ck1-dev/ESPuino/PCBs/Wemos Lolin D32 Pro ck1/espuino_lolin_d32_pro.kicad_pcb

## KiCad design PCBs/Wemos Lolin D32 Pro ck1/espuino_lolin_d32_pro.kicad_pcb (2021-09-25)

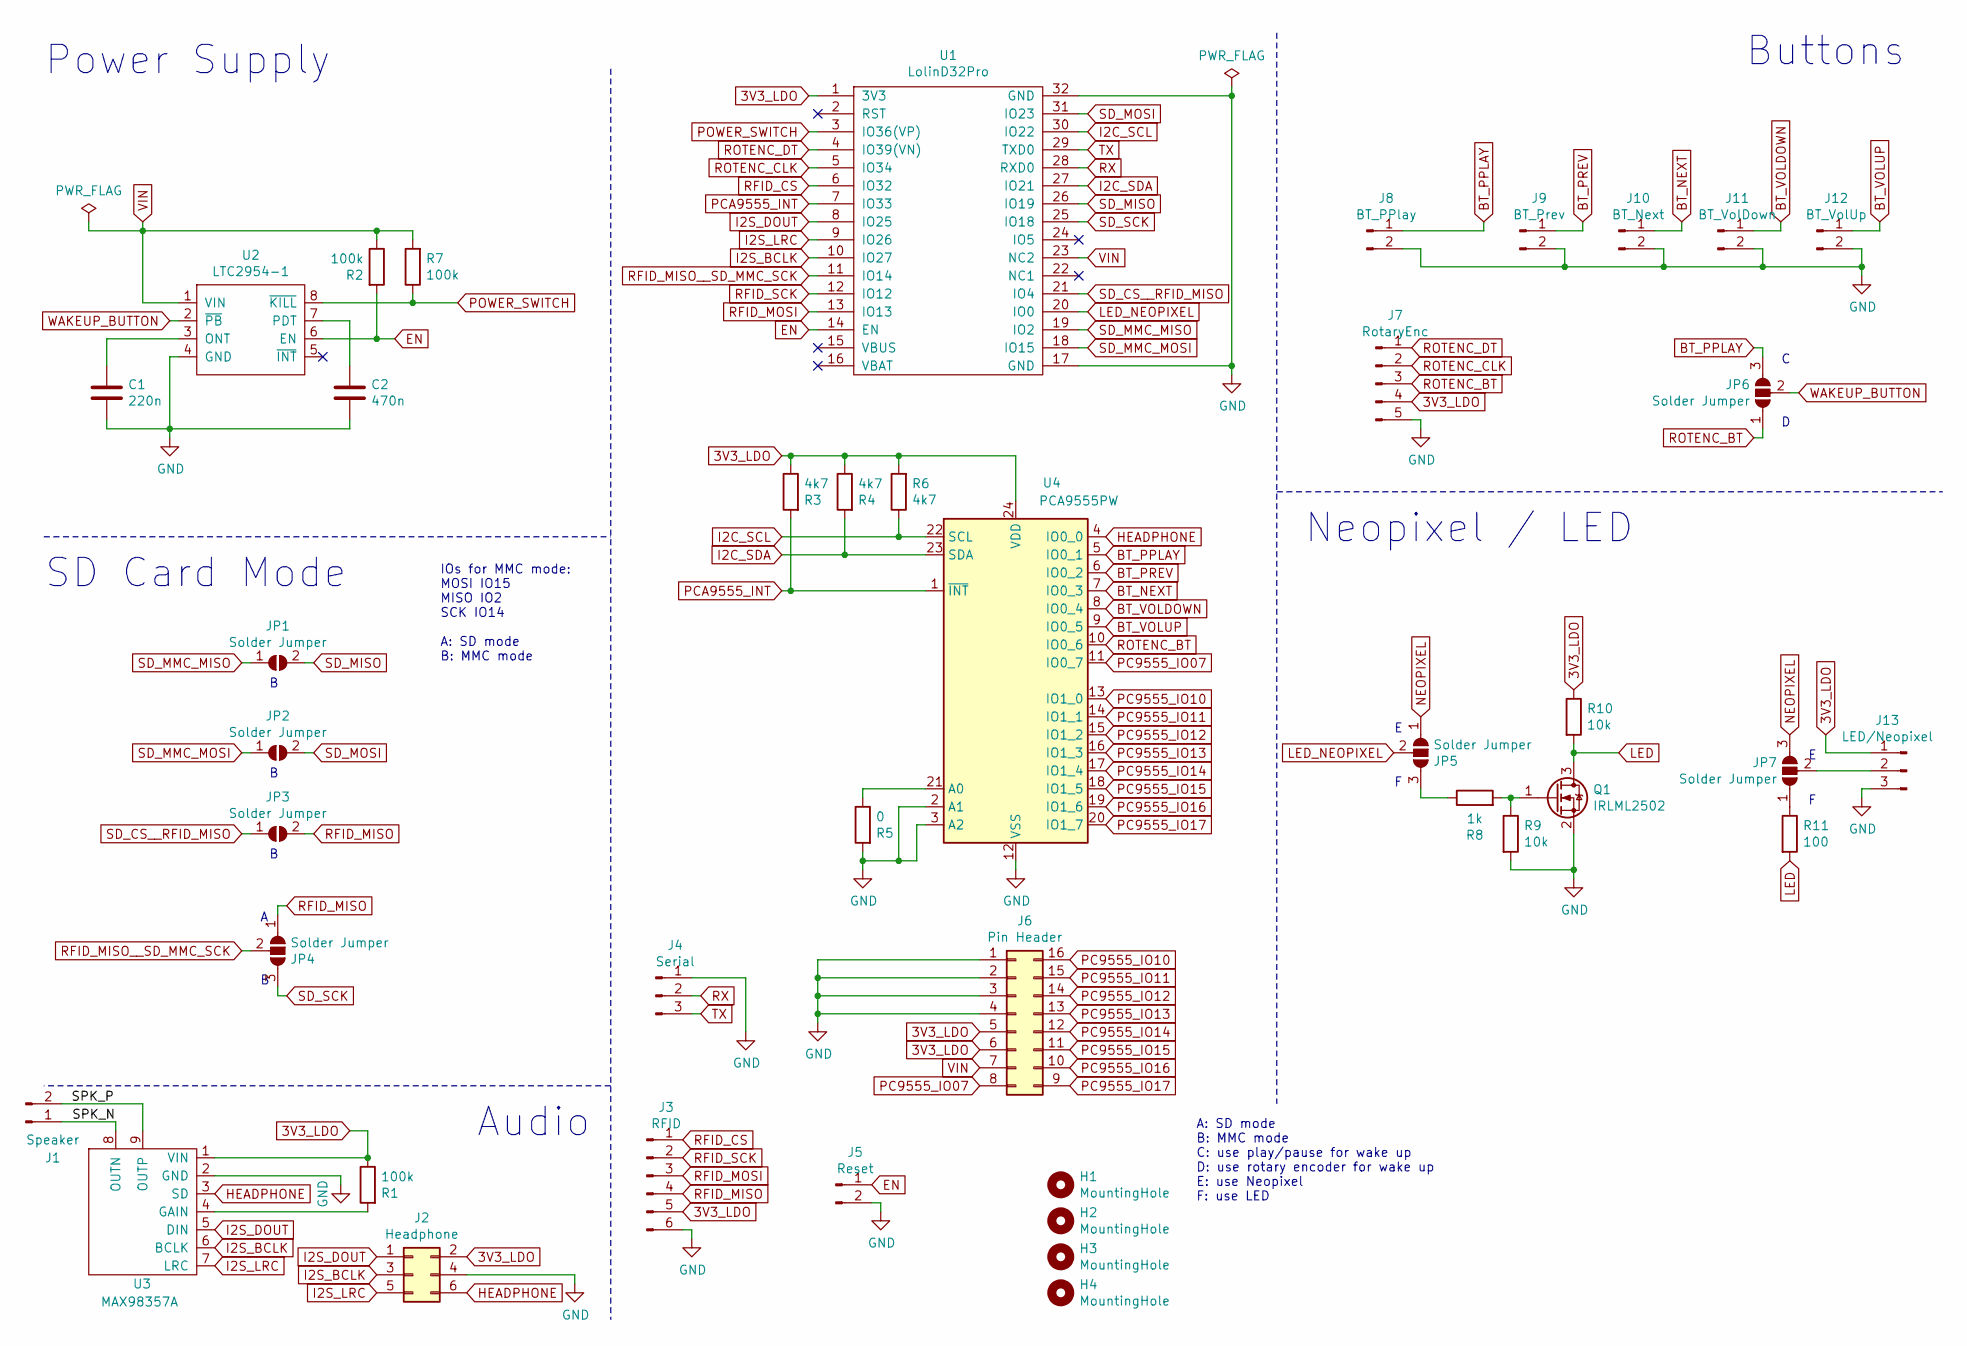
[picture p1: schematic espuino_lolin_d32_pro.sch, ESPuino D32 Pro by ck1]

Parts:
C1: 220n; C_0805_2012Metric_Pad1.18x1.45mm_HandSolder
C2: 470n; C_0805_2012Metric_Pad1.18x1.45mm_HandSolder
H1, H2, H3, H4: MountingHole; MountingHole_3mm
J1: Speaker; JST_PH_B2B-PH-K_1x02_P2.00mm_Vertical
J2: Headphone; IDC-Header_2x03_P2.54mm_Vertical
J3: RFID; JST_PH_B6B-PH-K_1x06_P2.00mm_Vertical
J4: Serial; PinHeader_1x03_P2.54mm_Vertical
J5: Reset; JST_PH_B2B-PH-K_1x02_P2.00mm_Vertical
J6: Pin Header; PinHeader_2x08_P2.54mm_Vertical
J7: RotaryEnc; JST_PH_B5B-PH-K_1x05_P2.00mm_Vertical
J8: BT_PPlay; JST_PH_B2B-PH-K_1x02_P2.00mm_Vertical
J9: BT_Prev; JST_PH_B2B-PH-K_1x02_P2.00mm_Vertical
J10: BT_Next; JST_PH_B2B-PH-K_1x02_P2.00mm_Vertical
J11: BT_VolDown; JST_PH_B2B-PH-K_1x02_P2.00mm_Vertical
J12: BT_VolUp; JST_PH_B2B-PH-K_1x02_P2.00mm_Vertical
J13: LED/Neopixel; JST_PH_B3B-PH-K_1x03_P2.00mm_Vertical
JP1, JP2, JP3: Solder Jumper; SolderJumper-2_P1.3mm_Open_Pad1.0x1.5mm
JP4, JP5, JP6, JP7: Solder Jumper; SolderJumper-3_P1.3mm_Open_Pad1.0x1.5mm
Q1: IRLML2502; SOT-23
R1, R2, R7: 100k; R_0805_2012Metric_Pad1.20x1.40mm_HandSolder
R3, R4, R6: 4k7; R_0805_2012Metric_Pad1.20x1.40mm_HandSolder
R5: 0; R_0805_2012Metric_Pad1.20x1.40mm_HandSolder
R8: 1k; R_0805_2012Metric_Pad1.20x1.40mm_HandSolder
R9, R10: 10k; R_0805_2012Metric_Pad1.20x1.40mm_HandSolder
R11: 100; R_0805_2012Metric_Pad1.20x1.40mm_HandSolder
U1: LolinD32Pro; Lolin_D32_PRO
U2: LTC2954-1; TSOT-23-8
U3: MAX98357A
U4: PCA9555PW; TSSOP-24_4.4x7.8mm_P0.65mm

Connections:
3V3_LDO: J2.2, J3.5, J6.5, J6.6, J7.4, J13.1, R1.1, R3.1, R4.1, R6.2, R10.1, U1.1 (3V3), U3.1 (VIN), U4.24 (VDD)
/SPK_N: J1.1, U3.8 (OUTN)
/SPK_P: J1.2, U3.9 (OUTP)
BT_NEXT: J10.1, U4.7 (IO0_3)
BT_PPLAY: J8.1, JP6.3 (B), U4.5 (IO0_1)
BT_PREV: J9.1, U4.6 (IO0_2)
BT_VOLDOWN: J11.1, U4.8 (IO0_4)
BT_VOLUP: J12.1, U4.9 (IO0_5)
EN: J5.1, R2.2, U1.14 (EN), U2.6 (EN)
GND: C1.2, C2.2, J2.4, J3.6, J4.1, J5.2, J6.1, J6.2, J6.3, J6.4, J7.5, J8.2, J9.2, J10.2, J11.2, J12.2, J13.3, Q1.2 (S), R5.2, R9.2, U1.17 (GND), U1.32 (GND), U2.4 (GND), U3.2 (GND), U4.2 (A1), U4.3 (A2), U4.12 (VSS)
HEADPHONE: J2.6, U3.3 (SD), U4.4 (IO0_0)
I2C_SCL: R6.1, U1.30 (IO22), U4.22 (SCL)
I2C_SDA: R4.2, U1.27 (IO21), U4.23 (SDA)
I2S_BCLK: J2.3, U1.10 (IO27), U3.6 (BCLK)
I2S_DOUT: J2.1, U1.8 (IO25), U3.5 (DIN)
I2S_LRC: J2.5, U1.9 (IO26), U3.7 (LRC)
LED: Q1.3 (D), R10.2, R11.2
LED_NEOPIXEL: JP5.2 (C), U1.20 (IO0)
NEOPIXEL: JP5.1 (A), JP7.3 (B)
unnamed: C1.1, U2.3 (ONT)
unnamed: C2.1, U2.7 (PDT)
unnamed: J13.2, JP7.2 (C)
unnamed: JP5.3 (B), R8.1
unnamed: JP7.1 (A), R11.1
unnamed: Q1.1 (G), R8.2, R9.1
unnamed: R1.2, U3.4 (GAIN)
unnamed: R5.1, U4.21 (A0)
PC9555_IO07: J6.8, U4.11 (IO0_7)
PC9555_IO10: J6.16, U4.13 (IO1_0)
PC9555_IO11: J6.15, U4.14 (IO1_1)
PC9555_IO12: J6.14, U4.15 (IO1_2)
PC9555_IO13: J6.13, U4.16 (IO1_3)
PC9555_IO14: J6.12, U4.17 (IO1_4)
PC9555_IO15: J6.11, U4.18 (IO1_5)
PC9555_IO16: J6.10, U4.19 (IO1_6)
PC9555_IO17: J6.9, U4.20 (IO1_7)
PCA9555_INT: R3.2, U1.7 (IO33), U4.1 (~INT)
POWER_SWITCH: R7.1, U1.3 (IO36(VP)), U2.8 (~KILL)
RFID_CS: J3.1, U1.6 (IO32)
RFID_MISO: J3.4, JP3.2 (B), JP4.1 (A)
RFID_MISO__SD_MMC_SCK: JP4.2 (C), U1.11 (IO14)
RFID_MOSI: J3.3, U1.13 (IO13)
RFID_SCK: J3.2, U1.12 (IO12)
ROTENC_BT: J7.3, JP6.1 (A), U4.10 (IO0_6)
ROTENC_CLK: J7.2, U1.5 (IO34)
ROTENC_DT: J7.1, U1.4 (IO39(VN))
RX: J4.2, U1.28 (RXD0)
SD_CS__RFID_MISO: JP3.1 (A), U1.21 (IO4)
SD_MISO: JP1.2 (B), U1.26 (IO19)
SD_MMC_MISO: JP1.1 (A), U1.19 (IO2)
SD_MMC_MOSI: JP2.1 (A), U1.18 (IO15)
SD_MOSI: JP2.2 (B), U1.31 (IO23)
SD_SCK: JP4.3 (B), U1.25 (IO18)
TX: J4.3, U1.29 (TXD0)
VIN: J6.7, R2.1, R7.2, U1.23 (NC2), U2.1 (VIN)
WAKEUP_BUTTON: JP6.2 (C), U2.2 (~PB)

Notes on the sheet:
Buttons
Power Supply
Audio
Neopixel / LED
SD Card Mode
IOs for MMC mode: MOSI IO15 MISO IO2 SCK IO14 A: SD mode B: MMC mode
A: SD mode B: MMC mode C: use play/pause for wake up D: use rotary encoder for wake up E: use Neopixel F: use LED

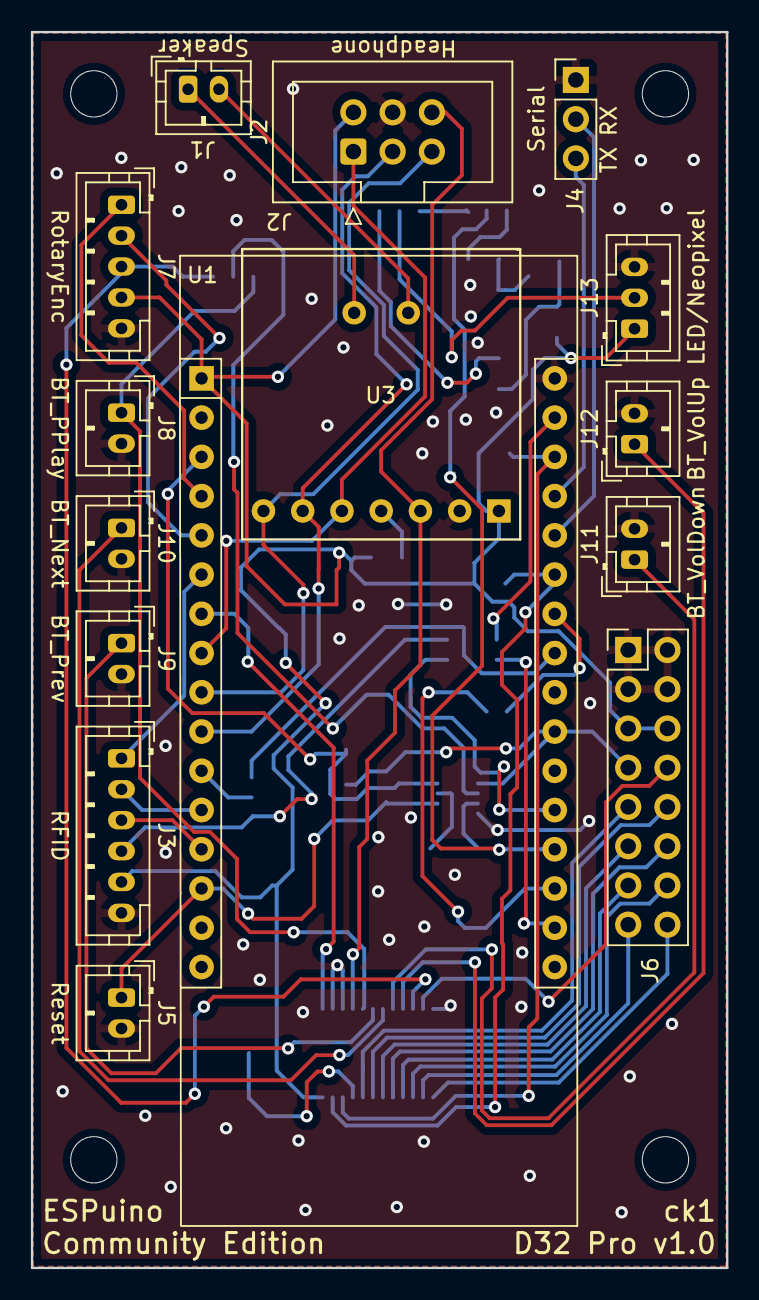
[picture p2: board espuino_lolin_d32_pro.kicad_pcb from above]

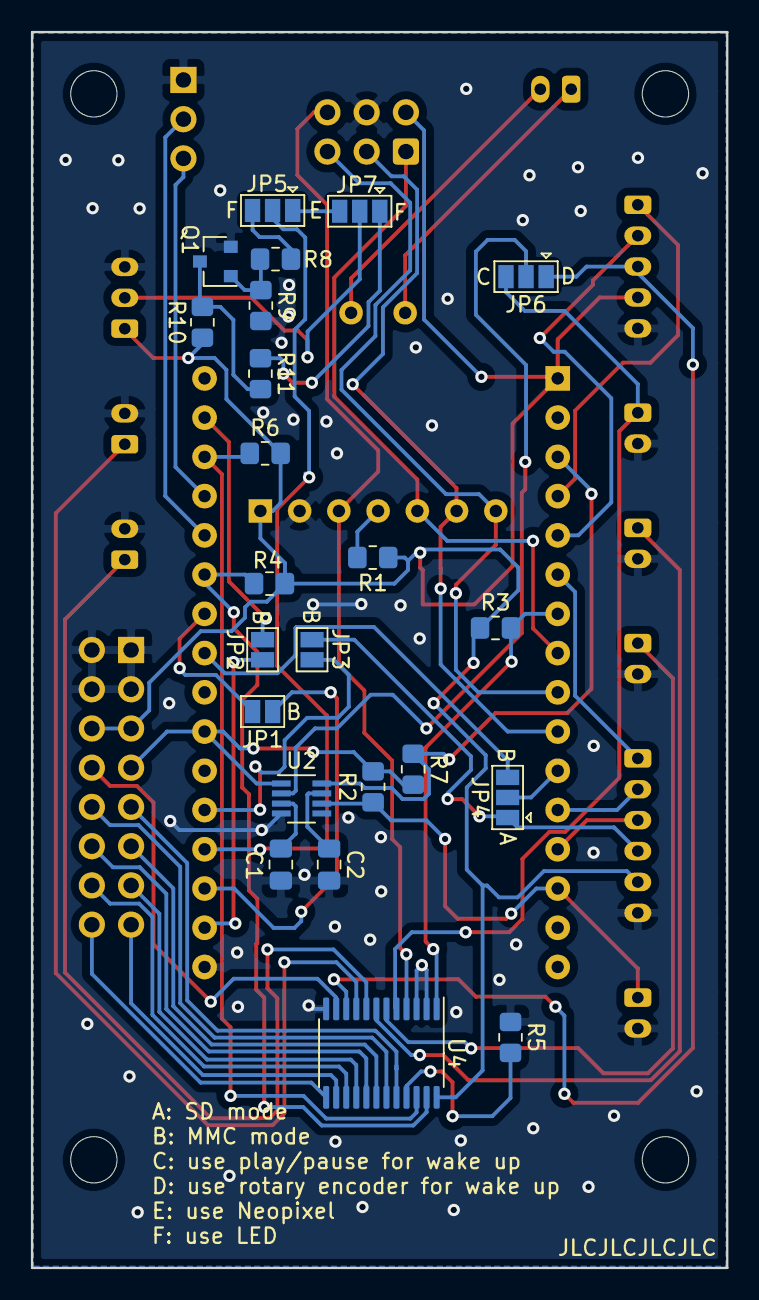
[picture p3: board espuino_lolin_d32_pro.kicad_pcb from below]

Board: 2 copper layers, 45.0 x 80.0 mm, 42 parts (23 on the bottom side), 56 nets.
