ck1-dev/ESPuino/(commit log)

2021-08-07 adapt settings to custom pcb
2021-08-14 power-down test
2021-09-12 switch next/prev track and volume up/down
2021-09-25 add copy of d32 pro pcb
    [espuino_lolin_d32_pro.kicad_pcb, espuino_lolin_d32_pro.sch]
2021-10-09 implement simple led status
2023-02-13 preparing updated original files for own d32 pcb
